jmshearer/FlappyFeet/NOTICES.md

# Third-Party Notices

This project incorporates material from the projects listed below. The original material was modified to create derived material used in this project. The kind gesture of these open-source contributors is gratefully acknowledged.

---

## canvas-confetti

- **License**: ISC License
- **Source**: [canvas-confetti GitHub Repository](https://github.com/catdad/canvas-confetti/)

ISC License

Copyright (c) 2020, Kiril Vatev

Permission to use, copy, modify, and/or distribute this software for any
purpose with or without fee is hereby granted, provided that the above
copyright notice and this permission notice appear in all copies.

THE SOFTWARE IS PROVIDED "AS IS" AND THE AUTHOR DISCLAIMS ALL WARRANTIES
WITH REGARD TO THIS SOFTWARE INCLUDING ALL IMPLIED WARRANTIES OF
MERCHANTABILITY AND FITNESS. IN NO EVENT SHALL THE AUTHOR BE LIABLE FOR
ANY SPECIAL, DIRECT, INDIRECT, OR CONSEQUENTIAL DAMAGES OR ANY DAMAGES
WHATSOEVER RESULTING FROM LOSS OF USE, DATA OR PROFITS, WHETHER IN AN
ACTION OF CONTRACT, NEGLIGENCE OR OTHER TORTIOUS ACTION, ARISING OUT OF
OR IN CONNECTION WITH THE USE OR PERFORMANCE OF THIS SOFTWARE.

---

## konami-js

- **License**: MIT License
- **Source**: [konami-js GitHub Repository](https://github.com/georgemandis/konami-js)

MIT License

Copyright (c) 2017 Snaptortoise

Permission is hereby granted, free of charge, to any person obtaining a copy
of this software and associated documentation files (the "Software"), to deal
in the Software without restriction, including without limitation the rights
to use, copy, modify, merge, publish, distribute, sublicense, and/or sell
copies of the Software, and to permit persons to whom the Software is
furnished to do so, subject to the following conditions:

The above copyright notice and this permission notice shall be included in all
copies or substantial portions of the Software.

THE SOFTWARE IS PROVIDED "AS IS", WITHOUT WARRANTY OF ANY KIND, EXPRESS OR
IMPLIED, INCLUDING BUT NOT LIMITED TO THE WARRANTIES OF MERCHANTABILITY,
FITNESS FOR A PARTICULAR PURPOSE AND NONINFRINGEMENT. IN NO EVENT SHALL THE
AUTHORS OR COPYRIGHT HOLDERS BE LIABLE FOR ANY CLAIM, DAMAGES OR OTHER
LIABILITY, WHETHER IN AN ACTION OF CONTRACT, TORT OR OTHERWISE, ARISING FROM,
OUT OF OR IN CONNECTION WITH THE SOFTWARE OR THE USE OR OTHER DEALINGS IN THE
SOFTWARE.

## Original Sprite Sheet

- **License**: Custom
- **Source**: [Spriters-Resource.com]([https://www.spriters-resource.com/fullview/59894/])

From [FAQ Page](https://www.spriters-resource.com/page/faq/)
That said, if your project is 100% free (e.g. a free fan-game or non-monetized YouTube video - basically any project that was made just for the sake of making it and will not be used in any way to make you money), use away! This is one of the primary reasons we collected all of these resources and we'd love to see what you do with them!
