jmshearer/FlappyFeet/Game/assets/qr.png

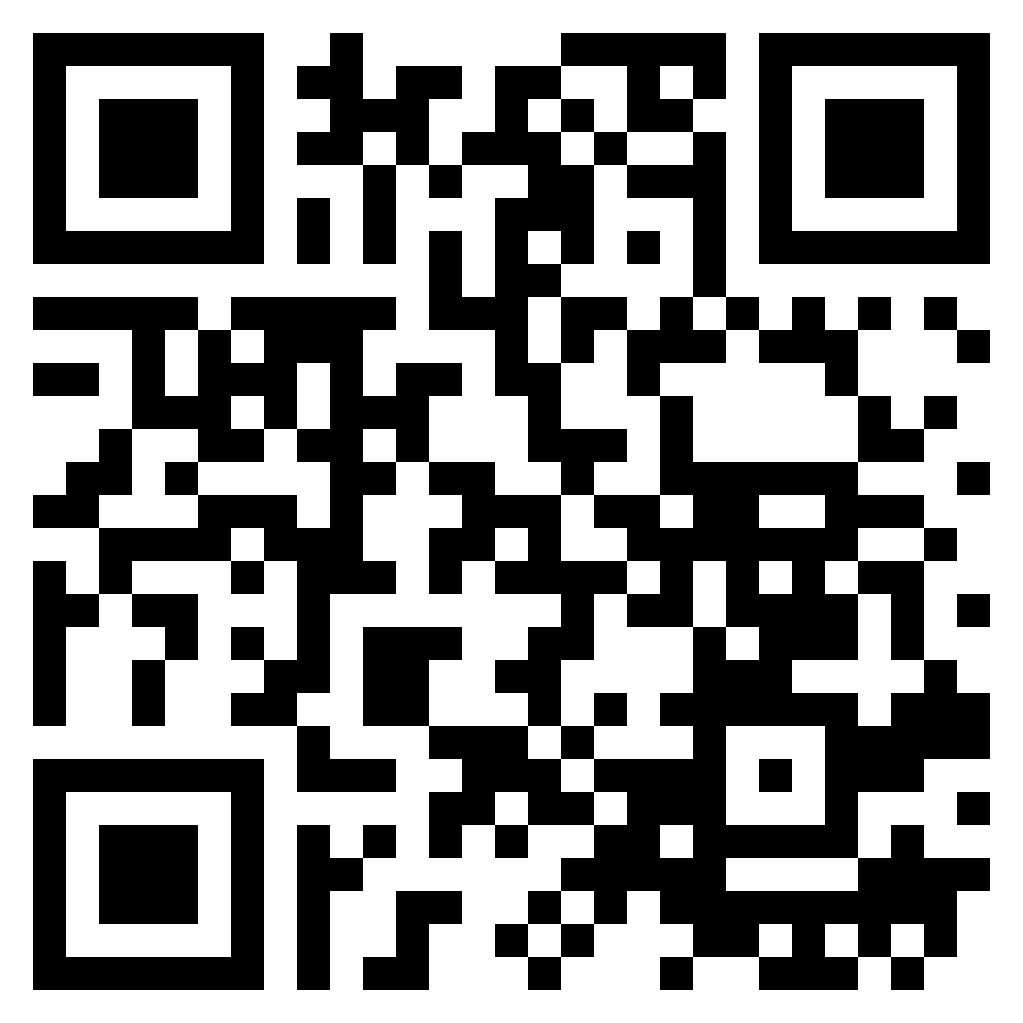
Game/assets/qr.png
