jmshearer/FlappyFeet/Game/assets/sprites.png

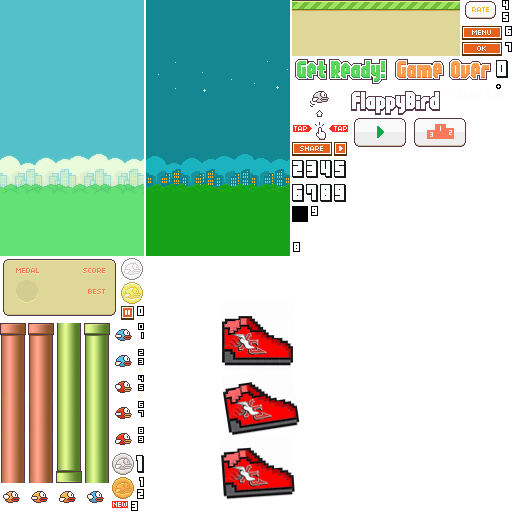
Game/assets/sprites.png
