jmshearer/FlappyFeet/(commit log)

2023-10-20 Cleaned up schematic
2024-10-18 Add UltraSonic Joystick Interface
2024-10-18 Update schematic
